sdeghuee/SpeakEasy/README.md

# SpeakEasy
[Back to Team Page](https://engineering.purdue.edu/477grp2/index.html)

ECE 477 Senior Design
