sdeghuee/SpeakEasy/PCB/3dmodels/SSW-103-02-G-S-RA.stp

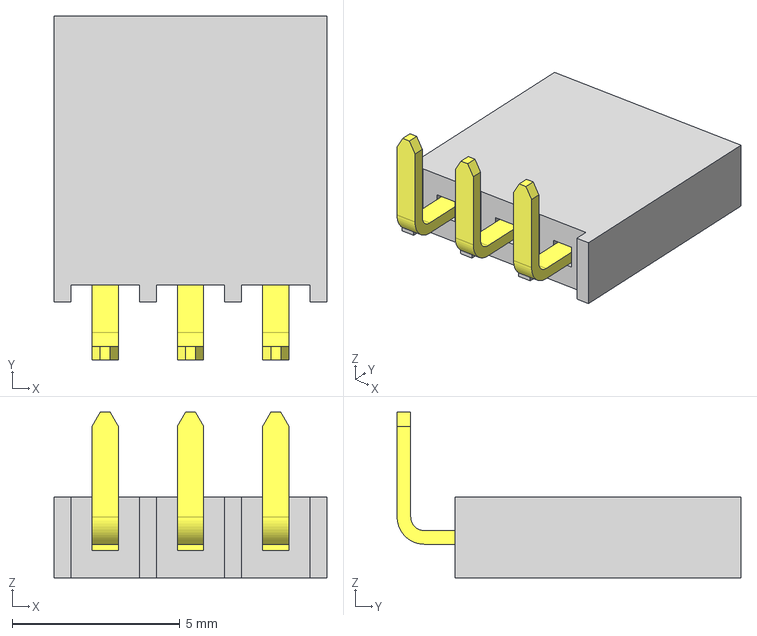
[picture p1: CAD file, 2018-10-13]
PCB/3dmodels/SSW-103-02-G-S-RA.stp
8.13 x 10.2 x 4.94 mm
_T1SSW-103-02-G-S-RA
_P2SSW-103-02-G-S-RA
