sdeghuee/SpeakEasy/PCB/3dmodels/TPSM84205.stp

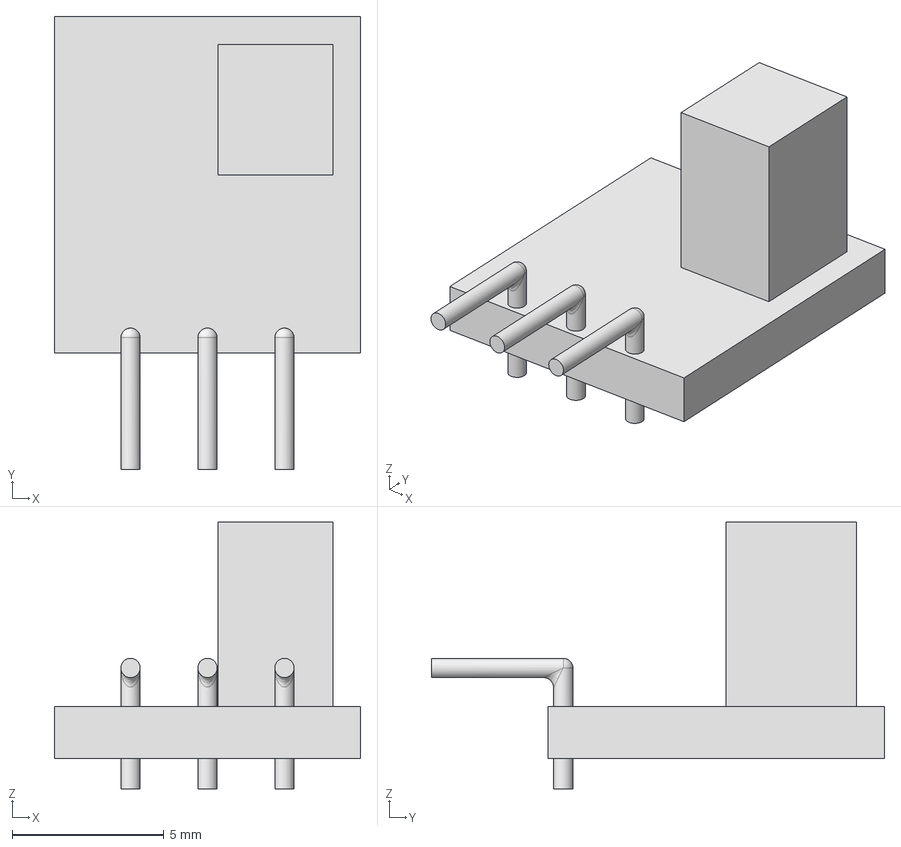
[picture p2: CAD file, 2018-10-13]
PCB/3dmodels/TPSM84205.stp
10.1 x 14.9 x 8.80 mm
