sdeghuee/SpeakEasy/PCB/SpeakEasy_Full.pdf

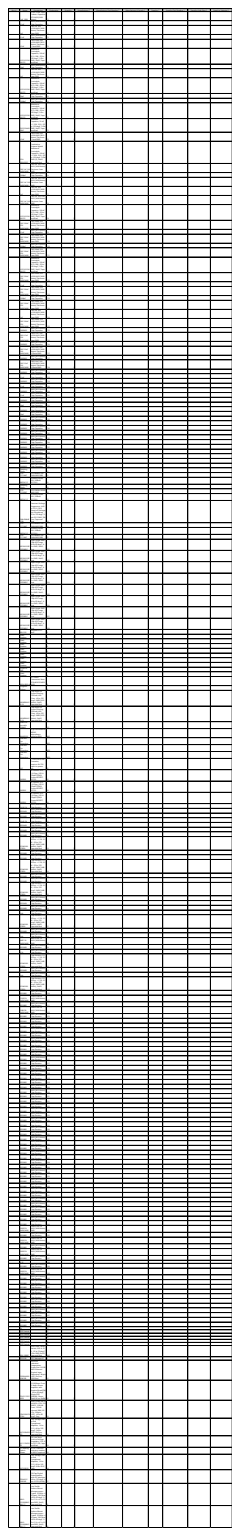
[picture p23: page 1]

Line # Name 0.1µF ±10% 100V Ceramic Capacitor Description .1uF 100V X7S 0603 (1608 Metric) | Designator C1 | Quantity | Manufacturer 1 1 | Manufacturer Part Number 1 | Manufacturer Lifecycle 1 | Supplier 1 | Supplier Part Number 1 | Supplier Unit Price 1 | Supplier Subtotal 1

0.1uF 0603 (1608 Metric) Chip Capacitor CAP 1uF 25V ±10% 0603 (1608 Metric) Thickness 1uF 1mm SMD | C1 C1 | 1 1

0.1uF 0603 (1608 Metric) Chip Capacitor .47uF CAP 470nF 50V ±20% 0805 (2012 Metric) Thickness 1.1mm SMD | C2 C2 | 1 1

Aluminum Electrolytic Capacitor, 100 uF, UCL1V101M 35 V, 20%, -55 to 105 degC, 2-Pin SMD, RoHS, Tape NL1GS and Reel 0603 (1608 Metric) | C3 | 1

18pF Chip Capacitor 1uF CAP 1uF 25V ±10% 0603 (1608 Metric) Thickness 1mm SMD | C3 C3 | 1 1

Aluminum Electrolytic Capacitor, 100 uF, UCL1V101M NL1GS 35 V, 20%, -55 to 105 degC, 2-Pin SMD, RoHS, Tape and Reel | C4 | 1

18pF 0805 (2012 Metric) 0603 (1608 Metric) Chip Capacitor 1000pF Aluminum Electrolytic Chip Capacitor UCL1V101M Capacitor, 100 uF, 35 V, 20%, -55 to 105 degC, 2-Pin SMD, RoHS, Tape NL1GS and Reel | C4 C4 C5 | 1 1 1

Tantalum Capacitor, 10 uF, T491D106K0 +/- 10%, 35 V, -55 to SMD, RoHS, Tape 125 degC, 2-Pin 35AT and Reel | C5 | 1

±20% 0805 (2012 Metric) Thickness CAP 470nF 50V .47uF 1.1mm SMD | C5 | 1

Conductive Polymer Hybrid Aluminum Electrolytic EEH-Capacitor, 100 uF, +/- 20%, 50 V, -55 to SMD (G), RoHS, 105 degC, 2-Pin ZA1H101P Tape and Reel | C6 | 1

CAP 1uF 16V ±5% 0603 (1608 Metric) CAP 1uF 16V 0603(1608) Thickness 1mm SMD | C6 | 1

0805 (2012 Metric) CAP 1uF 16V 1000pF CAP 1uF 16V ±5% 0603 (1608 Metric) Thickness 1mm Chip Capacitor 0603(1608) SMD | C6 C7 | 1 1

CAP 1uF 25V ±10% 0603 (1608 1uF Metric) Thickness 1mm SMD CAP 1uF 16V ±5% | C7 | 1

CAP 1uF 16V 0603(1608) 0603 (1608 Metric) Thickness 1mm SMD | C8 | 1

Aluminum Electrolytic Capacitor, 100 uF, 35 V, 20%, -55 to UCL1V101M NL1GS 105 degC, 2-Pin SMD, RoHS, Tape and Reel | C8 | 1

CAP 100nF 25V 0603(1608) CAP 100nF 25V ±20% 0603 (1608 Metric) Thickness 1mm SMD | C9 | 1

0.1uF CAP 100nF 25V 0805 (2012 Metric) Chip Capacitor CAP 100nF 25V 0603(1608) ±20% 0603 (1608 Metric) Thickness 1mm SMD | C9 C10 | 1 1

CAP 100nF 1000pF CAP 100nF 25V ±20% 0603 (1608 Chip Capacitor 0805 (2012 Metric) 25V 0603(1608) Metric) Thickness 1mm SMD | C10 C11 | 1 1

Aluminum Electrolytic Capacitor, 100 uF, 35 V, 20%, -55 to UCL1V101M NL1GS 105 degC, 2-Pin SMD, RoHS, Tape and Reel | C11 | 1

CAP 100nF 25V CAP 100nF 25V 0603(1608) ±20% 0603 (1608 Metric) Thickness 1mm SMD | C12 | 1

0.1uF 0805 (2012 Metric) Chip Capacitor CAP 100nF 25V CAP 100nF 25V 0603(1608) ±20% 0603 (1608 Metric) Thickness 1mm SMD | C12 C13 | 1 1

0805 (2012 Metric) CAP 100nF 1000pF CAP 100nF 25V ±20% 0603 (1608 Chip Capacitor 25V 0603(1608) Metric) Thickness 1mm SMD | C13 C14 | 1 1

CAP 1uF 25V 1uF ±10% 0603 (1608 Metric) Thickness 1mm SMD | C14 | 1

CAP 100nF 25V CAP 100nF 25V 0603(1608) ±20% 0603 (1608 Metric) Thickness 1mm SMD | C15 | 1

CAP0805 CAP 4.7uF 10V 0805 (2012 Metric) Chip Capacitor CAP 4.7uF 10V 0603(1608) ±20% 0603 (1608 Metric) Thickness 1mm SMD | C15 C16 | 1 1

0805 (2012 Metric) CAP 2.2uF CAP0805 CAP 2.2uF 16V ±20% 0603 (1608 Chip Capacitor 16V 0603(1608) Metric) Thickness 0.55mm SMD | C16 C17 | 1 1

0805 (2012 Metric) CAP 2.2uF CAP0805 CAP 2.2uF 16V ±20% 0603 (1608 Chip Capacitor 16V 0603(1608) Metric) Thickness 0.55mm SMD | C17 C18 | 1 1

LTST-LED AMBER CLR C171AKT Schottky Diode, 30V ,200mW, THIN 0805 SMD BAT54-7-F SOT23-3 | D3 D3 | 1 1

LTST-C171AKT LED AMBER CLR THIN 0805 SMD APFA3010SE Chip LED Lamp, 40 to 85 degC, 4-Pin Right Angle SMD SMD, RoHS, EZGQBDC Reel | D? -DS1 | 1 1

Right Angle SMD Chip LED Lamp, APFA3010SE EZGQBDC 40 to 85 degC, 4-Pin Reel SMD, RoHS, Right Angle SMD | -DS2 | 1

APFA3010SE Chip LED Lamp, 40 to 85 degC, 4-Pin SMD, RoHS, EZGQBDC Reel | -DS3 | 1

Right Angle SMD Chip LED Lamp, APFA3010SE EZGQBDC 40 to 85 degC, 4-Pin Reel SMD, RoHS, | -DS4 | 1

APFA3010SE Chip LED Lamp, 40 to 85 degC, 4-Pin Right Angle SMD SMD, RoHS, EZGQBDC Reel | -DS5 | 1

Right Angle SMD Chip LED Lamp, APFA3010SE EZGQBDC 40 to 85 degC, 4-Pin Reel SMD, RoHS, | -DS6 | 1

APFA3010SE Right Angle SMD Chip LED Lamp, 40 to 85 degC, 4-Pin SMD, RoHS, EZGQBDC Reel | -DS7 | 1

Right Angle SMD Chip LED Lamp, APFA3010SE EZGQBDC 40 to 85 degC, 4-Pin Reel SMD, RoHS, | -DS8 | 1

Stack Headers ARJ-199 Jack MagJack POE+ Stack Stack Headers Stack Headers Headers Stack Headers Stack SJ-43514-Stack Headers Headers Stack Headers SMT DC Power Connectors 2mm PCB JACK POWER KLDX-0202-A Program-JACK | J1 J1 J1 J2 J2 J2 J3 J3 J4 J4 J5 | 1 1 1 1 1 1 1 1 1 1 1

Debug Power Filtering, 1500 mA, 600 Ohm, -40 to 125 Chip Bead for MI0805K601 R-10 degC, 0805 (2012 Metric), RoHS, Tape and Reel | J5 L1 | 1 1

Chip Bead for Power Filtering, 1500 mA, 600 Ohm, -40 to 125 MI0805K601 R-10 degC, 0805 (2012 Metric), RoHS, Tape and Reel | L2 | 1

Made for use 20AWG with | LS1 | 1

IM69D120 High Performance MEMS microphone utilizing PDM | MK1 | 1

Standoff For Mounting | MP1 | 1

Standoff For Mounting | MP2 | 1

Standoff For Mounting +12V/2.5A DC/DC Converter, requires 36-75V input to power ULT on. | MP3 PS | 1 1

N-channel 60 V, 1.8 Ohm, 0.35 A 2N7002 STripFET(TM) II Power MOSFET, SOT23 | Q1 | 1

N-channel 60 V, 1.8 Ohm, 0.35 A STripFET(TM) II Power MOSFET, 2N7002 SOT23 | Q2 | 1

N-channel 60 V, 1.8 Ohm, 0.35 A 2N7002 STripFET(TM) II Power MOSFET, SOT23 | Q3 | 1

0603 (1608 Metric) RES0603 24.9K 1% 0603 (1608 Metric) Chip Resistor Chip Resistor RES0805 0603 (1608 Metric) 0805 (2012 Metric) Chip Resistor RES0603 63.4R 1% 0603 (1608 Metric) Chip Resistor Chip Resistor RES0805 0805 (2012 Metric) Chip Resistor 0805 (2012 Metric) RES0805 Chip Resistor, 2.2 KOhm, +/- 5%, 0.1 W, Chip Resistor -55 to 155 RC0603JR-072K2L degC, 0603 (1608 Metric), RoHS, Tape and Reel | R1 R1 R1 R2 R2 R2 R3 R3 | 1 1 1 1

RES0805 0805 (2012 Metric) Chip Resistor 0805 (2012 Metric) RES0805 Chip Resistor, 2.2 KOhm, +/- 5%, 0.1 W, Chip Resistor -55 to 155 RC0603JR-072K2L degC, 0603 (1608 Metric), RoHS, Tape and Reel | R3 R4 R4 | 1 1 1

RES0805 0805 (2012 Metric) Chip Resistor 0805 (2012 Metric) RES0805 KOhm, +/- 5%, 0.1 W, Chip Resistor, 2.2 Chip Resistor -55 to 155 RC0603JR-072K2L degC, 0603 (1608 Metric), RoHS, Tape and Reel | R4 R5 R5 | 1 1 1

RES0805 Chip Resistor 4K87 1% 3.6k 4K87 0.1W 1% 0603 (1608 Metric) Chip Resistor 0805 (2012 Metric) 0603(1608) SMD | R7 R8 R8 | 1 1 1

RES0805 0805 (2012 Metric) Chip Resistor 9.1k Chip Resistor, 2.2 0805 (2012 Metric) Chip Resistor RC0603JR-KOhm, +/- 5%, 0.1 W, degC, 0603 (1608 Metric), RoHS, -55 to 155 072K2L Tape and Reel | R8 R9 R9 | 1 1 1

RES0805 0805 (2012 Metric) Chip Resistor 3.6k Chip Resistor, 2.2 0805 (2012 Metric) Chip Resistor KOhm, +/- 5%, 0.1 W, degC, 0603 (1608 Metric), RoHS, -55 to 155 RC0603JR-072K2L Tape and Reel | R9 R10 R10 | 1 1 1

RES0805 0805 (2012 Metric) Chip Resistor 510R 5% 0603(1608) 510R 0.1W 5% 0603 (1608 Metric) SMD | R10 R11 | 1 1

RES0805 0805 (2012 Metric) Chip Resistor 300R 5% 0603(1608) 100K 0.1W 5% 0603 (1608 Metric) SMD 0805 (2012 Metric) | R35 R36 | 1 1

TPS2378 Industrial Temperature POE Manager IC PHYTER® Single Port 10/100 Mb/s Ethernet Physical Layer DP83848IVV X/NOPB Transceiver, 48-pin LQFP, Pb-Free, 1000 Reel | U U1 | 1 1

10 W Mono Class-D Amplifier with Audio Power SpeakerGuard(TM) , 28-pin SOP -40 to 85 degC, TPA3111D1P WPR (PWP28), Green (RoHS & no Sb/Br) | U1 | 1

bit MCU+FPU, 210 ARM Cortex-M4 32-DMIPS, 1024 kB Flash, 192 kB Internal RAM, 82 STM32F407V GT6U I/Os, 100-pin LQFP, -40 to 85 degC, Tray Low Voltage, Rail- | U2 | 1

to-Rail Operational Amplifier, 1.8 to MC33204DR 12 V, -40 to 105 degC, 14-Pin SOIC, Pb-Free, 2G Tape and Reel 1A, Low Drop | U2 | 1

Positive Voltage LD1117AS33 TR Regulator, 3.3V, Pin and Reel SOT-223, Tape | 4-U3 | 1

2/1 Analog A 2 to 1 mux for Switch Muxer reducing number of ADCs required | U3 | 1

Low Voltage, Rail-to-Rail Operational Amplifier, 1.8 to 12 V, -40 to 105 MC33201D degC, 8-Pin SOIC, Tube | U4 | 1

128 Tap Digital Potentiometer with I2C Interface, TPL0401C-50DCKR -40 to 125 degC, pin SOT23 (DCK6) | 6-U? | 1

Low Profile Surface Mount Microprocessor Crystal, 25 MHz ABLS-25.000MHZ-30 ppm, 180 Ohm, -40 to 85 degC, 2-Pin mm SMD, RoHS, 11.4 x 4.7 x 3.3 B4-F-T Tape and Reel | +/-X1 | 1

Low Profile Surface Mount Microprocessor Crystal, 25 MHz ABLS-25.000MHZ-30 ppm, 180 Ohm, -40 to 85 degC, 2-Pin mm SMD, RoHS, 11.4 x 4.7 x 3.3 B4-F-T Tape and Reel | +/-X2 | 1
