sdeghuee/SpeakEasy/sim/Coupling_Block.asc

C1: cap; 22p
D1: zener
D2: zener
L1: ind2; 1m; Rser=.1
L2: ind2; 1m
R2: res; 7.5Meg
Named nets: 0, Coup, decoup
K1 L1 L2 1
