sdeghuee/SpeakEasy/sim/SpeakEasy.asc

A1: modulate; mark=2meg space=.1K
A2: and; Vhigh=5 Vlow=0
A3: modulate; mark=2meg space=.1K
B1: bv; V=V(data)*V(mod)/5
B2: bv; V=(white(20e3*time)/.1)
B3: bv; V=(pow(V(d2),2) + pow(V(!d1),2))*3
C1: cap; 4.7p
C2: cap; 1n
C3: cap; 10µ
C4: cap; 47p
C5: cap; .1n
C6: cap; 1n
C7: cap; .1n
C8: cap; 10p
C9: cap; 6.8p
C10: cap; .47p
C11: cap; 3.3p
C12: cap; 15p
C13: cap; 1.5p
C14: cap; 1.5p
C15: cap; 1.5p
C16: cap; 47p
R1: res; 1k
R2: res; 1k
R3: res; 0
R4: res; 12.5k
R5: res; 13k
R6: res; 120k
R7: res; 1k
R8: res; 2.2k
R9: res; 9.1k
R10: res; 2.2k
R11: res; 4.3k
R12: res; 11k
R13: res; 12.5k
R14: res; 39k
R15: res; 110k
R16: res; 24k
R17: res; 4.7k
R19: res; 27k
R20: res; 5.1k
R21: res; 8.2k
R22: res; 1k
R23: res; 330
R27: res; 1k
R28: res; 2k
U1: opamp; Aol=10Meg
U2: opamp; Aol=10Meg
U3: opamp; Aol=10Meg
U4: opamp; Aol=10Meg
U5: opamp; Aol=10Meg
U6: opamp; Aol=10Meg
U7: opamp; Aol=10Meg
U8: opamp; Aol=10Meg
U9: AD8091
U10: opamp
V1: voltage; PULSE(0 5 0 .1u .1u 5u 10u)
V2: voltage; PULSE(0 5 0 0 0 15u 30u)
V3: voltage; 5
V4: voltage; 1
V5: voltage; 2.5
V6: voltage; -2.5
V7: voltage; SINE(.5 .5 20k)
V8: voltage; 12
V9: voltage; 1
V10: voltage; SINE(0 170 60)
V11: voltage; PULSE(0 5 0 0 0 .25u .5u)
X1: Coupling_Block
X2: Coupling_Block
Named nets: 0, +2.5V, -2.5V, audio, +5V, fmpre, +12V, data, mod, datasim, ook, +1V, dataam, recv, Noise, 120VAC, dataout, !d1, d1, d2, +comp
.tran 90u
OOK Circuit
High Pass To get to SIN wave for OOK
.lib opamp.sub
Digital Data
Problems:
1. Amplifying 100Meg signals for demodulation
2. differential vs non driving opamp pros cons? 
3. Lower Frequency carrier easier to couple. (L of signal trans?)
4. simulating demodulation, not working? 
5. simulating Log amplifier
