sdeghuee/SpeakEasy/sim/LEDBeatsandFreqs.asc

C1: cap; .1µ
C2: cap; 4.7µ
C3: cap; .01µ
C4: cap; .01µ
C5: cap; 2.2µ
C6: cap; 4.7µ
D1: diode
D2: LED
D3: LED
Q1: npn
R1: res; 1meg
R2: res; 47k
R3: res; 20k
R4: res; 1k
R5: res; 680
R6: res; 560k
R7: res; 39k
R8: res; 100k
R9: res; 470
R10: res; 20k
U1: opamp
U2: opamp
V1: voltage; SINE(0 1 1000)
V2: voltage; 5
Named nets: 0
.lib opamp.sub
.tran 100m
