sdeghuee/SpeakEasy/(list of files, drawings)

Other design files:
PCB/Amplifier.SchDoc
PCB/Audio_Connectors.SchDoc
PCB/Audio_Filters.SchDoc
PCB/Audio_Preperation.SchDoc
PCB/ColorOrgan_LEDs.SchDoc
PCB/Ethernet_Phy.SchDoc
PCB/Integrated_Library - 28.09.18 - 20.02/Integrated_Library - 28.09.18 - 20.02.PcbLib
PCB/Integrated_Library - 28.09.18 - 20.02/Integrated_Library - 28.09.18 - 20.02.SchLib
PCB/Logic_Connectors.SchDoc
PCB/Logic_Power.SchDoc
PCB/Logic_SE.SchDoc
PCB/SpeakEasy_Audio.PcbDoc
PCB/SpeakEasy_Audio.PrjPcb
PCB/SpeakEasy_Audio.SchDoc
PCB/SpeakEasy_Buck.SchDoc
PCB/SpeakEasy_Logic.PcbDoc
PCB/SpeakEasy_Logic.PrjPcb
PCB/SpeakEasy_Microphone.SchDoc
PCB/SpeakEasy_POE.SchDoc
PCB/SpeakEasy_Power.PcbDoc
PCB/SpeakEasy_Power.PrjPcb
PCB/SpeakEasy_Power.SchDoc
PCB/SpeakEasy_Power_Connectors.SchDoc
PCB/SpeakeEasy_Logic.SchDoc
