sdeghuee/SpeakEasy/SW/speakeasy_udp_sun/Inc/audio.h

#define __AUDIO_H
#ifdef __cplusplus
 extern "C" {
#endif
#include "pdm2pcm_glo.h"
#include "stm32f4xx_hal.h"
#define AUDIO_OUT_IRQ_PREPRIO           0x0E
#define I2S2                            SPI2
#define I2S2_CLK_ENABLE()               __HAL_RCC_SPI2_CLK_ENABLE()
#define I2S2_CLK_DISABLE()              __HAL_RCC_SPI2_CLK_DISABLE()
#define I2S2_SCK_PIN                    GPIO_PIN_10
#define I2S2_SCK_GPIO_PORT              GPIOB
#define I2S2_SCK_GPIO_CLK_ENABLE()      __HAL_RCC_GPIOB_CLK_ENABLE()
#define I2S2_SCK_AF                     GPIO_AF5_SPI2
#define I2S2_MOSI_PIN                   GPIO_PIN_3
#define I2S2_MOSI_GPIO_PORT             GPIOC
#define I2S2_MOSI_GPIO_CLK_ENABLE()     __HAL_RCC_GPIOC_CLK_ENABLE()
#define I2S2_MOSI_AF                    GPIO_AF5_SPI2
#define I2S2_DMAx_CLK_ENABLE()          __HAL_RCC_DMA1_CLK_ENABLE()
#define I2S2_DMAx_CLK_DISABLE()         __HAL_RCC_DMA1_CLK_DISABLE()
#define I2S2_DMAx_STREAM                DMA1_Stream3
#define I2S2_DMAx_CHANNEL               DMA_CHANNEL_0
#define I2S2_DMAx_IRQ                   DMA1_Stream3_IRQn
#define I2S2_DMAx_PERIPH_DATA_SIZE      DMA_PDATAALIGN_HALFWORD
#define I2S2_DMAx_MEM_DATA_SIZE         DMA_MDATAALIGN_HALFWORD
#define I2S2_IRQHandler                 DMA1_Stream3_IRQHandler
#define AUDIO_IN_IRQ_PREPRIO            0x0F
#define AUDIODATA_SIZE                  2
#define AUDIO_OK                        0
#define AUDIO_ERROR                     1
#define AUDIO_TIMEOUT                   2
#define WR_BUFFER_SIZE          			  4096/2
#define DEFAULT_AUDIO_IN_FREQ                 I2S_AUDIOFREQ_8K
#define DEFAULT_AUDIO_IN_BIT_RESOLUTION       16
#define DEFAULT_AUDIO_IN_CHANNEL_NBR          1
#define DEFAULT_AUDIO_IN_VOLUME               64
#define DEFAULT_PSC							  475*44100/DEFAULT_AUDIO_IN_FREQ
#define INTERNAL_BUFF_SIZE                    128*DEFAULT_AUDIO_IN_FREQ/16000*DEFAULT_AUDIO_IN_CHANNEL_NBR
#define PCM_OUT_SIZE                          DEFAULT_AUDIO_IN_FREQ/1000
#define CHANNEL_DEMUX_MASK                    0x55
#define DATACONSTANT 1000
#define HIGHSENSITIVITY 25
#define LOWSENSITIVITY -50
#define BASETHRESHOLD 300
#define THRESHOLDINCREMENT .5
#define THRESHOLDMULTIPLIER 1.0
#define DACDIVIDER 2
extern __IO uint16_t AudioInVolume;
#define DMA_MAX(_X_)                (((_X_) <= DMA_MAX_SZE)? (_X_):DMA_MAX_SZE)
#define HTONS(A)  ((((uint16_t)(A) & 0xff00) >> 8) | (((uint16_t)(A) & 0x00ff) << 8))
uint8_t BSP_AUDIO_OUT_Init(uint16_t OutputDevice, uint8_t Volume, uint32_t AudioFreq);
uint8_t BSP_AUDIO_OUT_Play(uint16_t* pBuffer, uint32_t Size);
void    BSP_AUDIO_OUT_ChangeBuffer(uint16_t *pData, uint16_t Size);
uint8_t BSP_AUDIO_OUT_Pause(void);
uint8_t BSP_AUDIO_OUT_Resume(void);
uint8_t BSP_AUDIO_OUT_Stop(uint32_t Option);
uint8_t BSP_AUDIO_OUT_SetVolume(uint8_t Volume);
void    BSP_AUDIO_OUT_SetFrequency(uint32_t AudioFreq);
uint8_t BSP_AUDIO_OUT_SetMute(uint32_t Cmd);
uint8_t BSP_AUDIO_OUT_SetOutputMode(uint8_t Output);
void    BSP_AUDIO_OUT_TransferComplete_CallBack(void);
void    BSP_AUDIO_OUT_HalfTransfer_CallBack(void);
void    BSP_AUDIO_OUT_Error_CallBack(void);
void  BSP_AUDIO_OUT_ClockConfig(I2S_HandleTypeDef *hi2s, uint32_t AudioFreq, void *Params);
void  BSP_AUDIO_OUT_MspInit(I2S_HandleTypeDef *hi2s, void *Params);
void  BSP_AUDIO_OUT_MspDeInit(I2S_HandleTypeDef *hi2s, void *Params);
uint8_t BSP_AUDIO_IN_Init(uint32_t AudioFreq, uint32_t BitRes, uint32_t ChnlNbr);
uint8_t BSP_AUDIO_IN_Record(I2S_HandleTypeDef hi2s, uint16_t *pData, uint32_t Size);
uint8_t BSP_AUDIO_IN_Stop(void);
uint8_t BSP_AUDIO_IN_Pause(void);
uint8_t BSP_AUDIO_IN_Resume(void);
uint8_t BSP_AUDIO_IN_SetVolume(uint8_t Volume);
uint8_t BSP_AUDIO_IN_PDMToPCM(uint16_t *PDMBuf, uint16_t *PCMBuf);
void    BSP_AUDIO_IN_TransferComplete_CallBack(void);
void    BSP_AUDIO_IN_HalfTransfer_CallBack(void);
void    BSP_AUDIO_IN_Error_Callback(void);
void  BSP_AUDIO_IN_ClockConfig(I2S_HandleTypeDef *hi2s, uint32_t AudioFreq, void *Params);
void  BSP_AUDIO_IN_MspInit(I2S_HandleTypeDef *hi2s, void *Params);
void  BSP_AUDIO_IN_MspDeInit(I2S_HandleTypeDef *hi2s, void *Params);
uint8_t audioProcess();
#ifdef __cplusplus
}
#endif
