sdeghuee/SpeakEasy/SW/speakeasy_udp_sun/Src/main.c

/**
  ******************************************************************************
  * @file           : main.c
  * @brief          : Main program body
  ******************************************************************************
  * This notice applies to any and all portions of this file
  * that are not between comment pairs USER CODE BEGIN and
  * USER CODE END. Other portions of this file, whether 
  * inserted by the user or by software development tools
  * are owned by their respective copyright owners.
  *
  * Copyright (c) 2018 STMicroelectronics International N.V. 
  * All rights reserved.
  *
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
  ******************************************************************************
  */
/* Includes ------------------------------------------------------------------*/
#include "main.h"
#include "stm32f4xx_hal.h"
#include "lwip.h"

/* USER CODE BEGIN Includes */
#include "udp_sun.h"
#include "audio.h"
/* USER CODE END Includes */

ADC_HandleTypeDef hadc1;

DAC_HandleTypeDef hdac;

I2C_HandleTypeDef hi2c1;

I2S_HandleTypeDef hi2s2;
DMA_HandleTypeDef hdma_spi2_rx;

TIM_HandleTypeDef htim2;
TIM_HandleTypeDef htim3;
TIM_HandleTypeDef htim4;

UART_HandleTypeDef huart2;

/* USER CODE BEGIN PV */

// timers
uint32_t msCount = 0;
uint8_t started = 0;

// button debounce
uint8_t buttonPress[5] = {0, 0, 0, 0, 0};
uint8_t buttonPrev[5] = {0, 0, 0, 0, 0};

// ethernet
extern struct netif gnetif;
uint8_t bufferReceived[10];
uint16_t playbackControlRx = NOP;
uint16_t playbackControl[2];

// audio
uint8_t playing = 1;
uint8_t adcDone = 0;
uint16_t audioData = 0;
uint16_t txBuffer[10 * (BUFF_SIZE + 1)];
uint32_t txIndex = 0;
uint8_t playbackStarted = 0;
uint16_t playbackIndex = 0;

// begin ryan
double ampFactor = 1;
uint16_t adcOffset = 2187;

//I2C INIT VARIABLES
uint8_t i2cAddress = 124;
uint8_t i2cMinResistance[2] = {0x00,0x00};
uint8_t i2cDefaultResistance[2] = {0x00, 0x0c};
uint8_t i2cErr = 0;
uint16_t minResHoldReq = 75;
uint16_t maxResHoldReq = 75;
uint16_t msBetweenToggle = 0;
uint8_t toggleNum = 0;

//MICROPHONE INIT VARIABLES
uint16_t datacMic;
const int BUFFER_OFFSET_NONE = 0;
typedef struct {
  int32_t offset;
  uint32_t fptr;
}Audio_BufferTypeDef;
uint8_t pHeaderBuff[44];
uint16_t WrBuffer[WR_BUFFER_SIZE];

__IO uint32_t AUDIODataReady = 0, AUDIOBuffOffset = 0;
static uint16_t RecBuf[PCM_OUT_SIZE];/* PCM stereo samples are saved in RecBuf */
static uint16_t InternalBuffer[INTERNAL_BUFF_SIZE];
__IO uint32_t ITCounter = 0;
int micindex = 0, restart = 0, micOffset = 2048;
Audio_BufferTypeDef  BufferCtl;

//NOISE DETECTION INIT VARIABLES
uint8_t noiseLevel = 0;

uint8_t tmpToggle = 0;

//uint8_t convCplt = 0;
//uint16_t convCount = 0;
//uint16_t convSum = 0;

/* USER CODE END PV */

void SystemClock_Config(void);
static void MX_GPIO_Init(void);
static void MX_DMA_Init(void);
static void MX_DAC_Init(void);
static void MX_ADC1_Init(void);
static void MX_I2C1_Init(void);
static void MX_I2S2_Init(void);
static void MX_USART2_UART_Init(void);
static void MX_TIM2_Init(void);
static void MX_TIM3_Init(void);
static void MX_TIM4_Init(void);

/* USER CODE BEGIN PFP */
void debounceButton();
void checkButtonPress();
void checkADC();
void checkPlaybackControl();

// begin ryan
uint16_t amplify(uint16_t, double);
void I2C_SetMinResistance();
void I2C_SetDefaultResistance();
void Butt_PP();
void Butt_FF();
void Butt_RW();
void Butt_VolUp();
void Butt_VolDown();
void setGain(uint8_t);
/* USER CODE END PFP */

/* USER CODE BEGIN 0 */
void HAL_TIM_PeriodElapsedCallback(TIM_HandleTypeDef * htim) {
	if (htim->Instance == TIM2) {
		if (playbackStarted) {
//			HAL_DAC_SetValue(&hdac, DAC_CHANNEL_1, DAC_ALIGN_12B_R, txBuffer[playbackIndex++]);
			if (playbackIndex == 10 * BUFF_SIZE) {
				playbackIndex = 0;
			}
		}
		HAL_ADC_Start_IT(&hadc1);
//		if (started) {
//			audioData = convSum / convCount;
//			adcDone = 1;
//		}
//		convSum = 0;
//		convCount = 0;
//		convCplt = 1;
	}
	else if (htim->Instance == TIM3) {
		debounceButton();
		if (++msCount == 1000) {
			msCount = 0;
			if (!started) {
				started = 1;
				HAL_GPIO_WritePin(LED_Red_GPIO_Port, LED_Red_Pin, 0);
				HAL_GPIO_WritePin(LED_Amber_GPIO_Port, LED_Amber_Pin, 0);
			}
			setGain(noiseLevel);
		}
		if (++msBetweenToggle > 1000) {
			msBetweenToggle = 1000;
		}
		if(toggleNum > 0){
			switch(toggleNum % 2){
				case 1:
					if(msBetweenToggle >= minResHoldReq){
						I2C_SetDefaultResistance();
						msBetweenToggle = 0;
						toggleNum--;
					}
					break;
				case 0:
					if(msBetweenToggle >= maxResHoldReq){
						I2C_SetMinResistance();
						msBetweenToggle = 0;
						toggleNum--;
					}
					break;
			}
		}
//		if(i2cErr&&msCount == 0){
//			HAL_GPIO_TogglePin(LED_Amber_GPIO_Port,LED_Amber_Pin);
//			HAL_GPIO_TogglePin(LED_Red_GPIO_Port,LED_Red_Pin);
//		}
	}
	else if (htim->Instance == TIM4){
		if(AUDIODataReady){
			if(AUDIOBuffOffset == 0 )
			{
				if(micindex < WR_BUFFER_SIZE/2){
					datacMic = WrBuffer[micindex*2];
//					HAL_GPIO_WritePin(AMP_Gain0_GPIO_Port,AMP_Gain0_Pin,1);
				}else{
					AUDIODataReady = 0;
//					HAL_GPIO_WritePin(AMP_Gain0_GPIO_Port, AMP_Gain0_Pin,0);
//					HAL_GPIO_TogglePin(LED_Red_GPIO_Port,LED_Red_Pin);
					micindex = 0;
				}
			}else{
				restart = 0;
				if(micindex+AUDIOBuffOffset < WR_BUFFER_SIZE){
					datacMic = WrBuffer[micindex*2+AUDIOBuffOffset];
					datacMic = WrBuffer[micindex*2];
				}else{
					AUDIODataReady = 0;
					micindex = 0;
//					HAL_GPIO_TogglePin(AMP_Gain0_GPIO_Port, AMP_Gain0_Pin);
//					HAL_GPIO_TogglePin(GPIOD,GPIO_PIN_12);
				}
			}
		}
		if(AUDIODataReady){
			datacMic &= 0b1111111111110000;
			datacMic = datacMic>>4;
			if(datacMic > micOffset)
				datacMic-=micOffset;
			else if(datacMic<micOffset)
				datacMic += micOffset;
			micindex++;
			noiseLevel = audioProcess(audioData, datacMic, micOffset, adcOffset);
			HAL_DAC_SetValue(&hdac,DAC_CHANNEL_1,DAC_ALIGN_12B_R,datacMic);
		}
	}
}

void HAL_ADC_ConvCpltCallback(ADC_HandleTypeDef * hadc) {
	HAL_GPIO_WritePin(AMP_Gain1_GPIO_Port, AMP_Gain1_Pin, 0);
	audioData = HAL_ADC_GetValue(hadc);
	audioData = amplify(audioData, ampFactor);
	adcDone = 1;
//	convSum += HAL_ADC_GetValue(hadc);
//	convCount++;
//	if (convCount < 1) {
//		convCplt = 1;
//	}
}

void debounceButton() {
	uint8_t buttonIndex = msCount % 5;
	uint8_t buttonCurrent;
	switch (buttonIndex) {
		case 0:
			buttonCurrent = HAL_GPIO_ReadPin(PB_VolD_GPIO_Port, PB_VolD_Pin);
			break;
		case 1:
			buttonCurrent = HAL_GPIO_ReadPin(PB_Prev_GPIO_Port, PB_Prev_Pin);
			break;
		case 2:
			buttonCurrent = HAL_GPIO_ReadPin(PB_PlayPause_GPIO_Port, PB_PlayPause_Pin);
			break;
		case 3:
			buttonCurrent = HAL_GPIO_ReadPin(PB_Next_GPIO_Port, PB_Next_Pin);
			break;
		case 4:
			buttonCurrent = HAL_GPIO_ReadPin(PB_VolU_GPIO_Port, PB_VolU_Pin);
			break;
		default:
			buttonCurrent = 0;
			break;
	}
	buttonPress[buttonIndex] = !buttonPrev[buttonIndex] && buttonCurrent;
	buttonPrev[buttonIndex] = buttonCurrent;
}

void checkButtonPress() {
	for (uint8_t i = 0; i < 5; i++) {
	  if (buttonPress[i]) {
		  switch (i) {
			  case 0:
				  Butt_VolDown();
				  break;
			  case 1:
				  if (!toggleNum) {
					  Butt_RW();
				  }
				  break;
			  case 2:	//Play Pause
				  if (!toggleNum) {
					  Butt_PP();
				  }
				  playing ^= 1;
				  playbackControl[0] = Pause - playing;
				  udp_scratch_send(&playbackControl[0], 2);
				  break;
			  case 3:
				  if (!toggleNum) {
					  Butt_FF();
				  }
				  break;
			  case 4:
				  Butt_VolUp();
				  break;
			  default:
				  break;
		  }
	  }
	  buttonPress[i] = 0;
	}
}

void checkADC() {
	if (adcDone && started) {
		adcDone = 0;
		txBuffer[txIndex++] = audioData;
		if (txIndex % BUFF_SIZE == 0) {
			bufferReceived[(txIndex - 1) / BUFF_SIZE] = 0;
			udp_scratch_send_audio(&txBuffer[txIndex - BUFF_SIZE], BUFF_SIZE, (txIndex - 1) / BUFF_SIZE);
			if (!playbackStarted && txIndex == 6 * BUFF_SIZE) {
				playbackStarted = 1;
			}
			if (txIndex == 10 * BUFF_SIZE) {
				txIndex = 0;
			}
		}
	}
}

void checkPlaybackControl() {
	if (playbackControlRx != NOP) {
		switch (playbackControlRx) {
			case Vol_D:
				Butt_VolDown();
				break;
			case Prev:
				Butt_RW();
				break;
			case Play:
				Butt_PP();
				playing = 1;
				break;
			case Pause:
				Butt_PP();
				playing = 0;
				break;
			case Next:
				Butt_FF();
				break;
			case Vol_U:
				Butt_VolUp();
				break;
		}
		playbackControlRx = NOP;
//		HAL_GPIO_WritePin(AMP_Mute_GPIO_Port, AMP_Mute_Pin, playing);
	}
}

uint16_t amplify(uint16_t in, double factor){
	double out=adcOffset;
	if(in > adcOffset){
		out+=(in-adcOffset)*factor;
	}else{
		out-=(adcOffset-in)*factor;
	}
	return (uint16_t) out;
}
void I2C_SetMinResistance(){
	HAL_I2C_Master_Transmit(&hi2c1,i2cAddress,i2cMinResistance,2,10);
}
void I2C_SetDefaultResistance(){
	HAL_I2C_Master_Transmit(&hi2c1,i2cAddress,i2cDefaultResistance,2,10);
}
void Butt_PP(){
	toggleNum = 2;
}
void Butt_FF(){
	toggleNum = 4;
}
void Butt_RW(){
	toggleNum = 6;
}
void Butt_VolUp(){
	if(ampFactor < 1.5)
		ampFactor+=.1;
}
void Butt_VolDown(){
	if(ampFactor > .5)
		ampFactor-=.1;
}
void setGain(uint8_t level){
	  switch(level){
	  case 0:
		  playbackControl[0] = Gain0;
		  udp_scratch_send(&playbackControl[0], 2);
		  HAL_GPIO_WritePin(LED_Amber_GPIO_Port,LED_Amber_Pin,0);
		  HAL_GPIO_WritePin(LED_Red_GPIO_Port,LED_Red_Pin,0);
		  break;
	  case 1:
		  playbackControl[0] = Gain1;
		  udp_scratch_send(&playbackControl[0], 2);
		  HAL_GPIO_WritePin(LED_Amber_GPIO_Port,LED_Amber_Pin,0);
		  HAL_GPIO_WritePin(LED_Red_GPIO_Port,LED_Red_Pin,1);
		  break;
	  case 2:
		  playbackControl[0] = Gain2;
		  udp_scratch_send(&playbackControl[0], 2);
		  HAL_GPIO_WritePin(LED_Amber_GPIO_Port,LED_Amber_Pin,1);
		  HAL_GPIO_WritePin(LED_Red_GPIO_Port,LED_Red_Pin,0);
		  break;
	  case 3:
		  playbackControl[0] = Gain3;
		  udp_scratch_send(&playbackControl[0], 2);
		  HAL_GPIO_WritePin(LED_Amber_GPIO_Port,LED_Amber_Pin,1);
		  HAL_GPIO_WritePin(LED_Red_GPIO_Port,LED_Red_Pin,1);
		  break;
	  }
}
void BSP_AUDIO_IN_HalfTransfer_CallBack(void)
{
  /* PDM to PCM data convert */
  BSP_AUDIO_IN_PDMToPCM((uint16_t*)&InternalBuffer[0], (uint16_t*)&RecBuf[0]);

  /* Copy PCM data in internal buffer */
  memcpy((uint16_t*)&WrBuffer[ITCounter * (PCM_OUT_SIZE*2)], RecBuf, PCM_OUT_SIZE*4);

  BufferCtl.offset = BUFFER_OFFSET_NONE;

  if(ITCounter == (WR_BUFFER_SIZE/(PCM_OUT_SIZE*4))-1)
  {
    AUDIODataReady = 1;
    AUDIOBuffOffset = 0;
    ITCounter++;
  }
  else if(ITCounter == (WR_BUFFER_SIZE/(PCM_OUT_SIZE*2))-1)
  {
    AUDIODataReady = 1;
    AUDIOBuffOffset = WR_BUFFER_SIZE/2;
    ITCounter = 0;
    if(micindex != 0){
    	HAL_GPIO_WritePin(GPIOD,GPIO_PIN_13,1);
    }
    restart = 1;
  }
  else
  {
    ITCounter++;
  }
}
void BSP_AUDIO_IN_TransferComplete_CallBack(void)
{
  /* PDM to PCM data convert */
  BSP_AUDIO_IN_PDMToPCM((uint16_t*)&InternalBuffer[INTERNAL_BUFF_SIZE/2], (uint16_t*)&RecBuf[0]);

  /* Copy PCM data in internal buffer */
  memcpy((uint16_t*)&WrBuffer[ITCounter * (PCM_OUT_SIZE*2)], RecBuf, PCM_OUT_SIZE*4);

  BufferCtl.offset = BUFFER_OFFSET_NONE;

  if(ITCounter == (WR_BUFFER_SIZE/(PCM_OUT_SIZE*4))-1)
  {
    AUDIODataReady = 1;
    AUDIOBuffOffset = 0;
    ITCounter++;

  }
  else if(ITCounter == (WR_BUFFER_SIZE/(PCM_OUT_SIZE*2))-1)
  {
    AUDIODataReady = 1;
    AUDIOBuffOffset = WR_BUFFER_SIZE/2;
    ITCounter = 0;
    restart = 1;
    if(micindex != 0){
    	HAL_GPIO_WritePin(GPIOD,GPIO_PIN_13,1);
    }
  }
  else
  {
    ITCounter++;
  }
}
/* USER CODE END 0 */

/**
  * @brief  The application entry point.
  *
  * @retval None
  */
int main(void)
{
  /* MCU Configuration----------------------------------------------------------*/

  /* Reset of all peripherals, Initializes the Flash interface and the Systick. */
  HAL_Init();

  /* Configure the system clock */
  SystemClock_Config();

  /* Initialize all configured peripherals */
  MX_GPIO_Init();
  MX_DMA_Init();
  MX_LWIP_Init();
  MX_DAC_Init();
  MX_ADC1_Init();
  MX_I2C1_Init();
  MX_I2S2_Init();
  MX_USART2_UART_Init();
  MX_TIM2_Init();
  MX_TIM3_Init();
  MX_TIM4_Init();
  /* USER CODE BEGIN 2 */
	err_t errout = ethernetif_init(&gnetif);
	HAL_GPIO_WritePin(LED_Red_GPIO_Port, LED_Red_Pin, errout != ERR_OK);
	HAL_GPIO_WritePin(LED_Amber_GPIO_Port, LED_Amber_Pin, netif_is_up(&gnetif));
	udp_scratch_connect();
	HAL_DAC_Start(&hdac, DAC_CHANNEL_1);
	BSP_AUDIO_IN_Init(DEFAULT_AUDIO_IN_FREQ,DEFAULT_AUDIO_IN_BIT_RESOLUTION,DEFAULT_AUDIO_IN_CHANNEL_NBR);
	BSP_AUDIO_IN_Record(hi2s2,(uint16_t*)&InternalBuffer[0], INTERNAL_BUFF_SIZE);
	HAL_Delay(3000);
	HAL_TIM_Base_Start_IT(&htim2);
	HAL_TIM_Base_Start_IT(&htim3);
	HAL_TIM_Base_Start_IT(&htim4);
	I2C_SetDefaultResistance();
	playbackControl[1] = NOP;
  /* USER CODE END 2 */

  /* Infinite loop */
  /* USER CODE BEGIN WHILE */
	while (1)
	{
		ethernetif_set_link(&gnetif);
		ethernetif_input(&gnetif);
		checkButtonPress();
		checkADC();
		checkPlaybackControl();
//		if (convCplt) {
//			convCplt = 0;
//			HAL_GPIO_WritePin(AMP_Gain1_GPIO_Port, AMP_Gain1_Pin, 1);
//			HAL_ADC_Start_IT(&hadc1);
//		}
  /* USER CODE END WHILE */

  /* USER CODE BEGIN 3 */

	}
  /* USER CODE END 3 */

}

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
