sdeghuee/SpeakEasy/SW/speakeasy_udp_planet/speakeasy_udp_planet.ioc

Mcu.UserName=STM32F407VGTx
PA0-WKUP.GPIO_Label=MII_CRS
PA0-WKUP.Signal=ETH_CRS
PA1.GPIO_Label=MII_RX_CLK/RMII_REF_CLK
PA1.Signal=ETH_RX_CLK
PA10.GPIO_Label=PB_VolU
PA10.Signal=GPIO_Input
PA11.GPIO_Label=PB_Next
PA11.Signal=GPIO_Input
PA12.GPIO_Label=PHY_Reset
PA12.Signal=GPIO_Output
PA13.Signal=SYS_JTMS-SWDIO
PA14.Signal=SYS_JTCK-SWCLK
PA2.GPIO_Label=MII_MDIO
PA2.Signal=ETH_MDIO
PA3.GPIO_Label=MII_COL
PA3.Signal=ETH_COL
PA4.GPIO_Label=DAC_OUT
PA4.Signal=COMP_DAC1_group
PA5.GPIO_Label=ADC_HIGH_MID
PA5.Signal=ADCx_IN5
PA7.GPIO_Label=MII_RX_DV/RMII_CRSDV
PA7.Signal=ETH_RX_DV
PA8.GPIO_Label=PB_VolD
PA8.Signal=GPIO_Input
PB0.GPIO_Label=MII_RXD2
PB0.Signal=ETH_RXD2
PB1.GPIO_Label=MII_RXD3
PB1.Signal=ETH_RXD3
PB10.Signal=I2S2_CK
PB11.GPIO_Label=MII_TX_EN
PB11.Signal=ETH_TX_EN
PB12.GPIO_Label=MII_TXD0
PB12.Signal=ETH_TXD0
PB13.GPIO_Label=MII_TXD1
PB13.Signal=ETH_TXD1
PB14.GPIO_Label=MII_INT
PB14.Signal=GPXTI14
PB15.Signal=I2S2_SD
PB6.Signal=I2C1_SCL
PB7.Signal=I2C1_SDA
PB8.GPIO_Label=PB_Prev
PB8.Signal=GPIO_Input
PB9.Signal=I2S2_WS
PC0.GPIO_Label=ADC_LOW
PC0.Signal=ADCx_IN10
PC1.GPIO_Label=MII_MDC
PC1.Signal=ETH_MDC
PC2.GPIO_Label=MII_TXD2
PC2.Signal=ETH_TXD2
PC3.GPIO_Label=MII_TX_CLK
PC3.Signal=ETH_TX_CLK
PC4.GPIO_Label=MII_RXD0
PC4.Signal=ETH_RXD0
PC5.GPIO_Label=MII_RXD1
PC5.Signal=ETH_RXD1
PD11.GPIO_Label=ADC_Switch
PD11.Signal=GPIO_Output
PD12.GPIO_Label=LED_Red
PD12.Signal=GPIO_Output
PD13.GPIO_Label=LED_Amber
PD13.Signal=GPIO_Output
PD5.Signal=USART2_TX
PD6.Signal=USART2_RX
PD7.GPIO_Label=PHY_RX_ERR
PD7.Signal=GPIO_Input
PD8.GPIO_Label=PB_PlayPause
PD8.Signal=GPIO_Input
PE11.GPIO_Label=PWM_MID
PE11.Signal=S_TIM1_CH2
PE13.GPIO_Label=PWM_HIGH
PE13.Signal=S_TIM1_CH3
PE2.GPIO_Label=MII_TXD3
PE2.Signal=ETH_TXD3
PE3.GPIO_Label=AMP_Gain0
PE3.Signal=GPIO_Output
PE4.GPIO_Label=AMP_Gain1
PE4.Signal=GPIO_Output
PE5.GPIO_Label=AMP_Mute
PE5.Signal=GPIO_Output
PE9.GPIO_Label=PWM_LOW
PE9.Signal=S_TIM1_CH1
