sdeghuee/SpeakEasy/SW/eth_test_scratch/Src/main.c

/**
  ******************************************************************************
  * @file           : main.c
  * @brief          : Main program body
  ******************************************************************************
  * This notice applies to any and all portions of this file
  * that are not between comment pairs USER CODE BEGIN and
  * USER CODE END. Other portions of this file, whether 
  * inserted by the user or by software development tools
  * are owned by their respective copyright owners.
  *
  * Copyright (c) 2018 STMicroelectronics International N.V. 
  * All rights reserved.
  *
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
  ******************************************************************************
  */
/* Includes ------------------------------------------------------------------*/
#include "main.h"
#include "stm32f4xx_hal.h"
#include "lwip.h"

/* USER CODE BEGIN Includes */
#include "udp_scratch.h"
/* USER CODE END Includes */

ADC_HandleTypeDef hadc3;

DAC_HandleTypeDef hdac;

I2C_HandleTypeDef hi2c1;

SD_HandleTypeDef hsd;

TIM_HandleTypeDef htim2;
TIM_HandleTypeDef htim3;

UART_HandleTypeDef huart3;

NOR_HandleTypeDef hnor1;
SRAM_HandleTypeDef hsram2;
SRAM_HandleTypeDef hsram3;

/* USER CODE BEGIN PV */
struct netif gnetif;
uint32_t msCount = 0;
uint32_t clockCount = 0;
uint8_t buttonPress = 0;
uint8_t buttonPrev = 0;
uint32_t count = 0;
uint32_t value = 0;
uint8_t controlData[2];
uint8_t controlAddress = 124;
uint8_t control;
uint8_t delay = 128;
/*
 * 1 : play/pause
 * 2 : back
 * 3 : forward
 */
/* USER CODE END PV */

void SystemClock_Config(void);
static void MX_GPIO_Init(void);
static void MX_ADC3_Init(void);
static void MX_DAC_Init(void);
static void MX_FSMC_Init(void);
static void MX_I2C1_Init(void);
static void MX_SDIO_SD_Init(void);
static void MX_USART3_UART_Init(void);
static void MX_TIM2_Init(void);
static void MX_TIM3_Init(void);

/* USER CODE BEGIN PFP */

/* USER CODE END PFP */

/* USER CODE BEGIN 0 */
extern void HAL_ADC_ConvCpltCallback(ADC_HandleTypeDef * hadc) {
	value = HAL_ADC_GetValue(hadc);
	if (!HAL_GPIO_ReadPin(GPIOC, GPIO_PIN_13)) {
		uint8_t data[100];
		sprintf((char*) data, " %d ", (int) value);
		udp_scratch_send((char*) data);
	}
}

void i2c_play() {
	controlData[1] = 0x00;
	HAL_I2C_Master_Transmit(&hi2c1,controlAddress,controlData,2,10);
	controlData[1] = 0x0C;
	delay = 128;
}

void HAL_TIM_PeriodElapsedCallback(TIM_HandleTypeDef * htim) {
	if (htim->Instance == TIM2) {
		if (clockCount++ == 44) {
	//		HAL_GPIO_TogglePin(GPIOG, GPIO_PIN_8);
			clockCount = 0;
			msCount++;
			uint8_t buttonCurr = !HAL_GPIO_ReadPin(GPIOG, GPIO_PIN_15);
			buttonPress = !buttonPrev && buttonCurr;
			buttonPrev = buttonCurr;
			HAL_GPIO_WritePin(GPIOG, GPIO_PIN_8, netif_is_up(&gnetif));

			if (!HAL_GPIO_ReadPin(GPIOC, GPIO_PIN_13) && !HAL_GPIO_ReadPin(GPIOG, GPIO_PIN_15)) {
				uint8_t data[100];
				sprintf((char*) data, " %d ", count);
				udp_scratch_send((char*) data);
				count = 0;
			}
		}
		if (!delay) {
			HAL_I2C_Master_Transmit(&hi2c1,controlAddress,controlData,2,10);
			controlData[1] = 0x0C;
			delay = 128;
		}
		else {
			delay--;
		}
	}
	else if (htim->Instance == TIM3) {
		HAL_ADC_Start_IT(&hadc3);
	}
}

//void HAL_GPIO_EXTI_Callback(uint16_t GPIO_Pin)
//{
//  if (GPIO_Pin == GPIO_PIN_14)
//  {
//    ethernetif_set_link(&gnetif);
//  }
//}

/* USER CODE END 0 */

/**
  * @brief  The application entry point.
  *
  * @retval None
  */
int main(void)
{
  /* MCU Configuration----------------------------------------------------------*/

  /* Reset of all peripherals, Initializes the Flash interface and the Systick. */
  HAL_Init();

  /* Configure the system clock */
  SystemClock_Config();

  /* Initialize all configured peripherals */
  MX_GPIO_Init();
  MX_ADC3_Init();
  MX_DAC_Init();
  MX_FSMC_Init();
  MX_I2C1_Init();
  MX_SDIO_SD_Init();
  MX_USART3_UART_Init();
  MX_LWIP_Init();
  MX_TIM2_Init();
  MX_TIM3_Init();
  /* USER CODE BEGIN 2 */
  ethernetif_init(&gnetif);
  //udp_scratch_connect();
  udp_receive_init();
  HAL_TIM_Base_Start_IT(&htim2);
  HAL_TIM_Base_Start_IT(&htim3);
  if (netif_is_up(&gnetif)) {
	  HAL_GPIO_WritePin(GPIOG, GPIO_PIN_8, 1);
  }
  controlData[0] = 0x00;
  controlData[1] = 0x0C;
  /* USER CODE END 2 */

  /* Infinite loop */
  /* USER CODE BEGIN WHILE */
  while (1)
  {

  /* USER CODE END WHILE */

  /* USER CODE BEGIN 3 */
//	  ethernetif_set_link(&gnetif);
	  if (netif_is_up(&gnetif)) {
		  HAL_GPIO_WritePin(GPIOG, GPIO_PIN_8, 1);
		  ethernetif_input(&gnetif);
	  }
	  else {
		  HAL_GPIO_WritePin(GPIOG, GPIO_PIN_8, 0);
	  }
	  if (buttonPress) {
		  buttonPress = 0;
		  i2c_play();
//		  uint8_t data[100];
//		  sprintf((char*) data, " %d ", 100*(!HAL_GPIO_ReadPin(GPIOA, GPIO_PIN_0)));
//		  udp_scratch_send((char*) data);
		  HAL_GPIO_TogglePin(GPIOG, GPIO_PIN_6);
	  }
//	  if (!HAL_GPIO_ReadPin(GPIOC, GPIO_PIN_13) && !HAL_GPIO_ReadPin(GPIOG, GPIO_PIN_15)) {
//		  uint8_t data[100];
//		  sprintf((char*) data, " %d ", 100);
//		  udp_scratch_send((char*) data);
//		  HAL_GPIO_TogglePin(GPIOG, GPIO_PIN_6);
//		  count++;
//	  }
  }
  /* USER CODE END 3 */

}

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
