sdeghuee/SpeakEasy/(commit log)

2018-08-29 Differential driver + problem list
2018-09-03 beatsandfreq creation
    created beginning simulation based off of using 1k band pass. https://www.jameco.com/Jameco/Products/ProdDS/2155541Schematic.pdf
    need to look into different filter types and make design decisions
2018-09-27 Initial Altium Full Projet
    Initial Schematic Capture, PCB Layout and 3D model of all three PCBs
    [Amplifier.SchDoc, Audio_Connectors.SchDoc, ColorOrgan_LEDs.SchDoc, Ethernet_Phy.SchDoc, Logic_Connectors.SchDoc, Logic_Power.SchDoc, Logic_SE.SchDoc, SE_Lib.SchLib]
2018-09-29 Power Board 3D step file
    Power Board layout done (for now)
    3D step file has been extracted for use in mechancial design
    [Amplifier.SchDoc, Audio_Connectors.SchDoc, Audio_Preperation.SchDoc, Integrated_Library - 28.09.18 - 20.02.PcbLib, Integrated_Library - 28.09.18 - 20.02.SchLib, Logic_Connectors.SchDoc, Logic_SE.SchDoc, SE_Lib.SchLib]
2018-10-04 Latest PCB for Travel To CA
    Its so I can do flight stuff vrroooooom
    [Amplifier.SchDoc, Audio_Connectors.SchDoc, Audio_Filters.SchDoc, Logic_Connectors.SchDoc, Logic_Power.SchDoc, Logic_SE.SchDoc, SE_Lib.SchLib, SpeakEasy.PcbLib]
2018-10-08 Post CA changes
    Bom and other minor changse to hw
    [Amplifier.SchDoc, Audio_Connectors.SchDoc, Audio_Filters.SchDoc, Audio_Preperation.SchDoc, BOM.xlsx, ColorOrgan_LEDs.SchDoc, Ethernet_Phy.SchDoc, Logic_Connectors.SchDoc]
2018-10-11 Presentation final board layout + schematic
    David pls zip and upload k thanks
    [Audio_Connectors.SchDoc, Logic_Connectors.SchDoc, SpeakEasy_Audio.PcbDoc, SpeakEasy_Audio.PrjPcb, SpeakEasy_Audio.SchDoc, SpeakEasy_Audio.step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]
2018-10-11 God damn everything ryan
    god damnit ryan
    [Amplifier.SchDoc, SpeakEasy_Audio.PcbDoc]
2018-10-11 Added SpeakEasy Logo on all 3 PCBs
    [Amplifier.SchDoc, SpeakEasy_Audio.PcbDoc]
2018-10-11 Base functionality ethernet code
    Ethernet/lwIP: UDP send working on STM3240G-Eval
    [eth_test_scratch Debug.cfg]
2018-10-13 Push with actual latest thanks pictures
    project moved from incorrect location to actual github
    [Amplifier.SchDoc, Audio_Connectors.SchDoc, Audio_Filters.SchDoc, Audio_Preperation.SchDoc, BOM.xlsx, Ethernet_Phy.SchDoc, Logic_Connectors.SchDoc, Logic_Power.SchDoc]
2018-10-15 Release 1
    PCB that were ordered
    [SpeakEasy_Audio.PcbDoc, SpeakEasy_Audio.PrjPcb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]
2018-10-17 UDP receive code and I2C playback controls
    Code configured for receiving UDP messages (also includes functions for transmitting)
    I2C digital potentiometer controls also included
2018-11-12 working udp code for sending audio data, but no remote playback controls
    [speakeasy_udp_planet Debug.cfg, speakeasy_udp_sun Debug.cfg]
